cmerrill/icecube/README

This is a music-reactive "light cube" throwie.

Yaaaay! :D
