cmerrill/icecube/BeatDetect.brd

## EAGLE design BeatDetect.brd (2013-06-02)

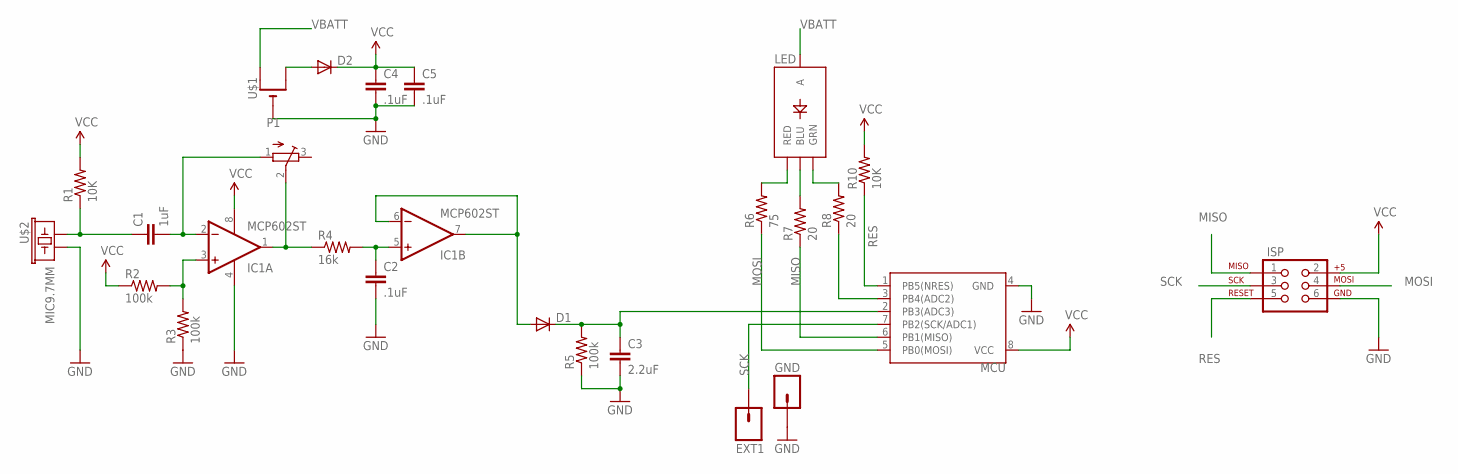
[picture p1: schematic BeatDetect.sch]

Parts:
C1: 1uF; 0805
C2, C4, C5: .1uF; 0603-CAP
C3: 2.2uF; 0805
D1, D2: DIODESOD; SOD-323
EXT1: M01PTH; 1X01
GND: M01PTH; 1X01
IC1: MCP602ST; TSSOP8
ISP: AVR_SPI_PRG_6PTH; 2X3
LED: LED-TRICOLORPLCC4; LED-PLCC4
MCU: ATTINY45X; TSSOP8
P1: TRIMPOTTC33X; TC33X
R1, R10: 10K; 0402-RES
R2, R3, R5: 100k; 0402-RES
R4: 16k; 0402-RES
R6: 75; 0805
R7, R8: 20; 0402-RES
U$1: CR2032SMT; CR2032-SMD
U$2: MIC9.7MM; MIC-9.7MM

Connections:
GND: C2.2, C3.2, C4.2, C5.2, GND.1, IC1.4 (V-), ISP.6, MCU.4 (GND), R3.1, R5.1, U$1.-, U$2.2
MISO: ISP.1, MCU.6 (PB1(MISO)), R7.1
MOSI: ISP.4, MCU.5 (PB0(MOSI)), R6.1
unnamed: D1.2 (A), IC1.6 (-IN), IC1.7 (OUT)
unnamed: C2.1, IC1.5 (+IN), R4.2
unnamed: IC1.1 (OUT), P1.2 (S), R4.1
unnamed: C1.1, R1.1, U$2.1
unnamed: C1.2, IC1.2 (-IN), P1.1 (A)
unnamed: IC1.3 (+IN), R2.2, R3.2
unnamed: D2.2 (A), U$1.+$2 (+1)
unnamed: MCU.3 (PB4(ADC2)), R8.1
unnamed: LED.R (RED), R6.2
unnamed: LED.G (GRN), R8.2
unnamed: LED.B (BLU), R7.2
unnamed: C3.1, D1.1 (C), MCU.2 (PB3(ADC3)), R5.2
RES: ISP.5, MCU.1 (PB5(NRES)), R10.1
SCK: EXT1.1, ISP.3, MCU.7 (PB2(SCK/ADC1))
VBATT: LED.A, U$1.+$1 (+)
VCC: C4.1, C5.1, D2.1 (C), IC1.8 (V+), ISP.2, MCU.8 (VCC), R1.2, R2.1, R10.2

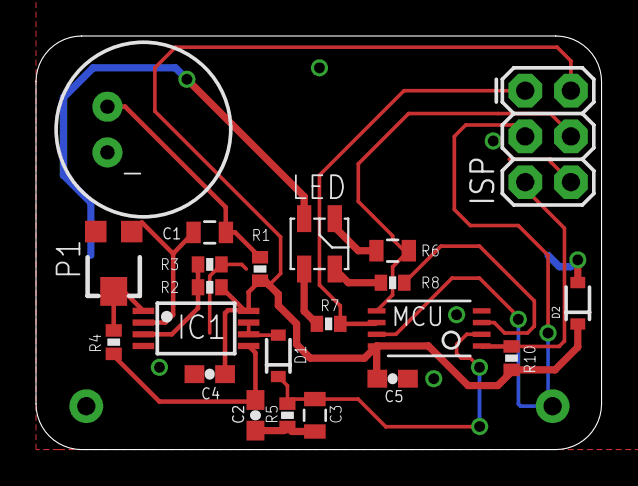
[picture p2: board BeatDetect.brd from above]

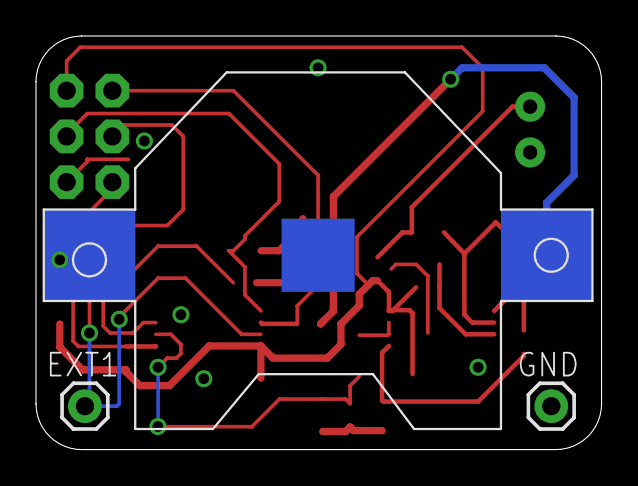
[picture p3: board BeatDetect.brd from below]

Board: 2 copper layers, 31.4 x 23.0 mm, 25 parts (3 on the bottom side), 19 nets.
