cmerrill/icecube/(commit log)

2013-06-01 Initial commit.
    Need to fix power separation between programming and LED power.
    [BeatDetect.brd, BeatDetect.sch]
2013-06-01 Fixing a bunch of small naming errors & part size mismatches.
    [BeatDetect.brd, BeatDetect.sch]
2013-06-02 Added power diode to isolate LED supply from MCU & etc. supply.
    Makes it a lot easier to safely program the MCU w/o turning the LED on
    and prevents backfriving current into the battery.
    [BeatDetect.brd, BeatDetect.sch]
2013-09-09 Let the main loop control the actual sleep command.
    This lets us turn the LEDs off and etc w/o breaking
    any abstractions.
2013-09-09 Fixing a few bugs noticed in the simulator.
    E.g. ADC was being turned off after starting conversion,
    off by one error on cycle timing.
    [beat_detect.c, main.c, sleep.c, sleep.h]
2013-09-16 Fix bug in watchdog configuration.
    [sleep.c]
